IlayAltay/Maks_Kontroller/README.md

# Maks_Kontroller 
полив грядок  
на базе платы макса для бассейна  ё 
4 кнопки  
LCD spi  
часы внешний кварц    
Рабочий вариант усеченый
