IlayAltay/Maks_Kontroller/Автополив-объединены.pdf

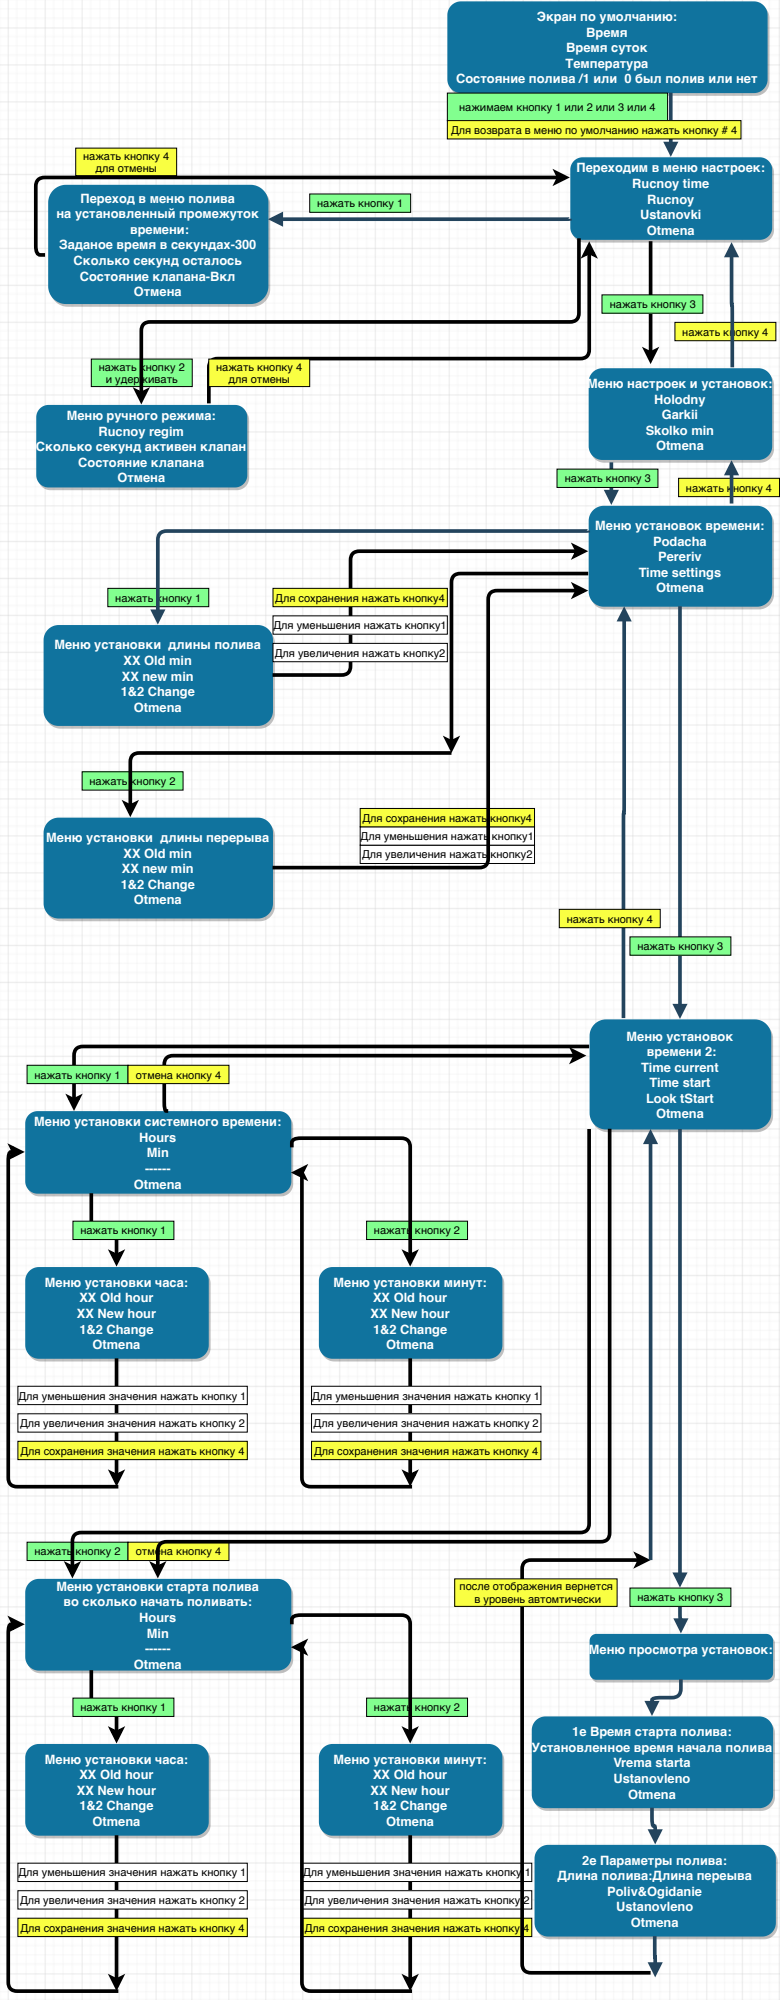
[picture p1: page 1]
Время Время суток Температура; Rucnoy time Rucnoy Ustanovki Otmena; времени:; Отмена; Состояние клапана Отмена; Holodny Garkii Skolko min Otmena; Podacha Pereriv Time settings Otmena; Меню установок времени 2: Time current Time start Look tStart Otmena; Vrema starta Ustanovleno Otmena; нажать кнопку 1; нажать кнопку 4 для отмены; нажать кнопку 2 и удерживать; нажать кнопку 3; нажать кнопку 2; нажать кнопку 4; Hours Min ------ Otmena; отмена кнопку 4; Poliv&Ogidanie Ustanovleno Otmena

Экран по умолчанию:

Состояние полива /1 или 0 был полив или нет

нажимаем кнопку 1 или 2 или 3 или 4

Для возврата в меню по умолчанию нажать кнопку # 4

Переходим в меню настроек:

Переход в меню полива
на установленный промежуток

Заданое время в секундах-300
Сколько секунд осталось
Состояние клапана-Вкл

Меню настроек и установок:

Меню ручного режима:
Rucnoy regim

Сколько секунд активен клапан

Меню установок времени:

Для сохранения нажать кнопку4

Для уменьшения нажать кнопку1

Меню установки длины полива

ХХ Old min
XX new min
1&2 Change
Otmena

Для увеличения нажать кнопку2

Меню установки длины перерыва

Меню установки системного времени:

Меню установки часа:
ХХ Old hour
XX New hour

Меню установки минут:

Для уменьшения значения нажать кнопку 1

Для увеличения значения нажать кнопку 2

Для сохранения значения нажать кнопку 4

Меню установки старта полива
во сколько начать поливать:

после отображения вернется
в уровень автомтически

Меню просмотра установок:

1е Время старта полива:

Установленное время начала полива

2е Параметры полива:
Длина полива:Длина переыва

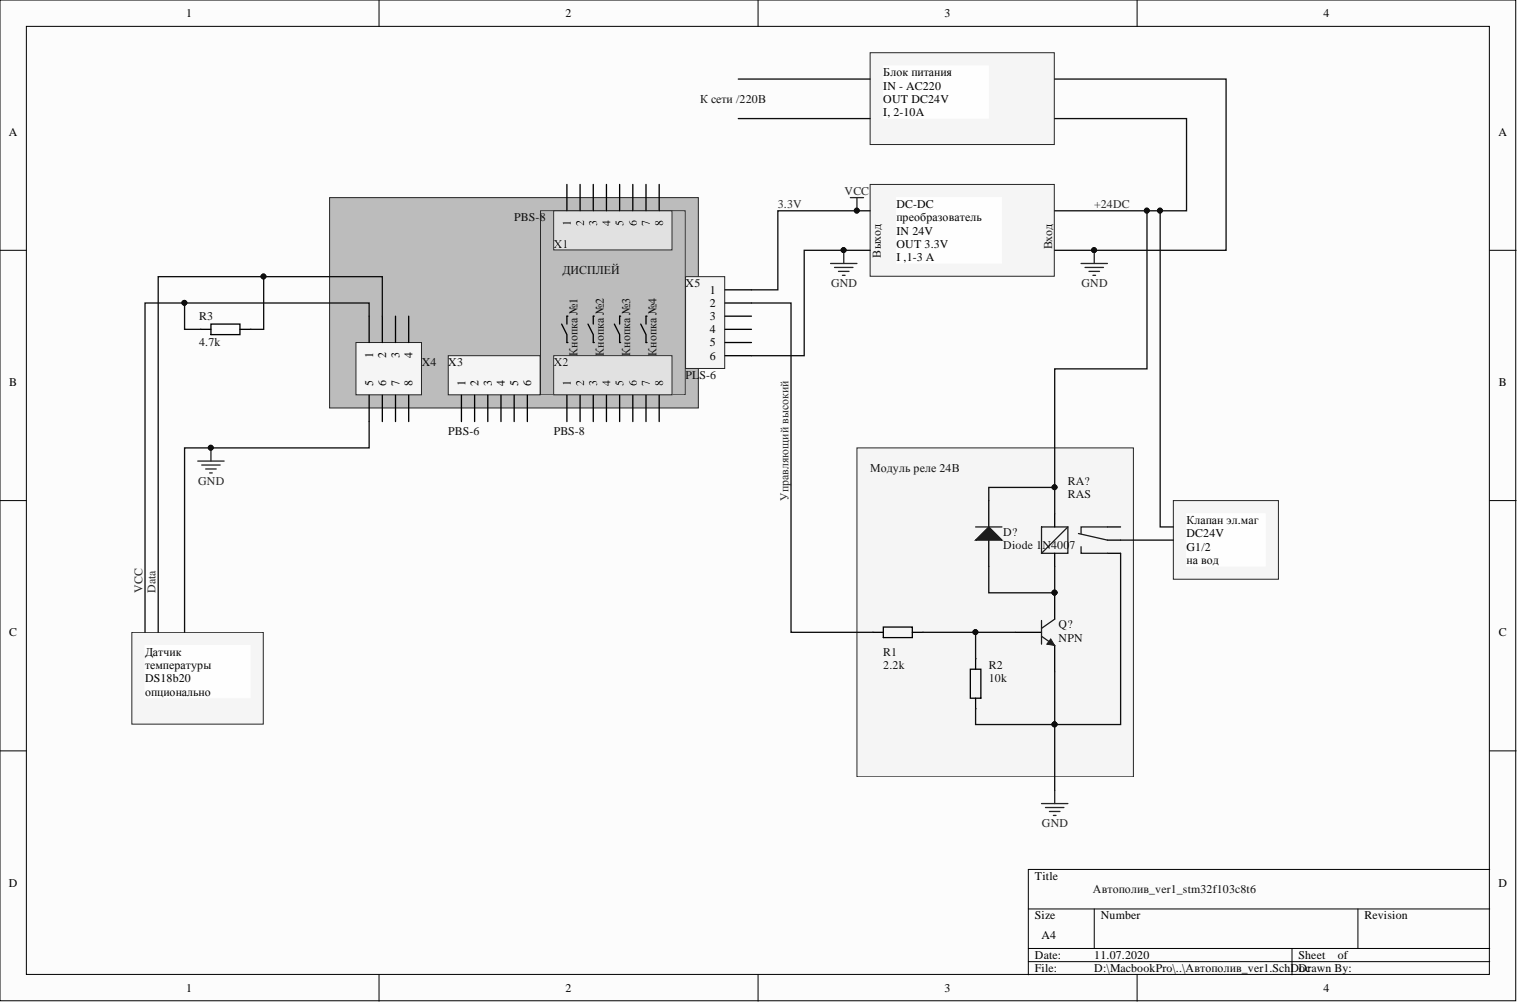
[picture p2: page 3]
Size; umber; Rev; Date:; Sheet o; \Macb; kPro; Авто; ver1.Sch; Docraw; ver1; PBS-8; PBS-6; PLS-6; ИСП; Кнопка №1; Кнопка №2; Кнопка №3; Кнопка №4; итан; К сети /; рео; раз; овател; Вход; Выход; DVCC; ? NPN; рел; Клапан; .маг; Управляющий высокий; Датч; к температу; нал; VCC; Data

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
D | D
C | C
B | B
A | A

Title

Size | Number | Revision

A4

Date: | 11.07.2020 | Sheet of
File: | D:\MacbookPro\..\Автополив_ver1_распиDнrawовкаn Byраз:ьемов.SchDoc

разьем Х1
Входит в плату
соединения с дисплеем
OLED
Распиновка:
1-GND
2-PC8 Светодиод+
3-PA5 -spi sck
4-PA6 -spi miso
5-PA7 -spi mosi
6-PB11 -Data/command
7-PB10 -CSelect
8-VCC +3.3

Разьем X2
Соединения с
кнопками
Входит в плату
соединения с дисплеем
OLED
Распиновка:
1-GND
2-GND
3-NRST
4-PB2
5-PB1
6-PB0
7-PC5

Разьем Х3
Для пргограмматора
Распиновка:
1-PB3 spi1
2-PC0
3-SWDIO
4-GND
5-SWCLK
6-VCC 3.3V

Разьем Х4
Для моудля NRF
Использован для DS18B20
Распиновка:
1-VCC
2-PA3 -data for ds18b20
3-к пин.5 Х1
4-PC4
5-GND
6-PA4
7-К пин3 Х1
8-к пин4 Х1

Разьем Х5
Внешний
Распиновка:
1-VCC
2-PC9 подключен вывод
реле полива
3-PB15 spi_mosi
4-PB13 spi_sck
5-PB14 spi_miso
6-GND

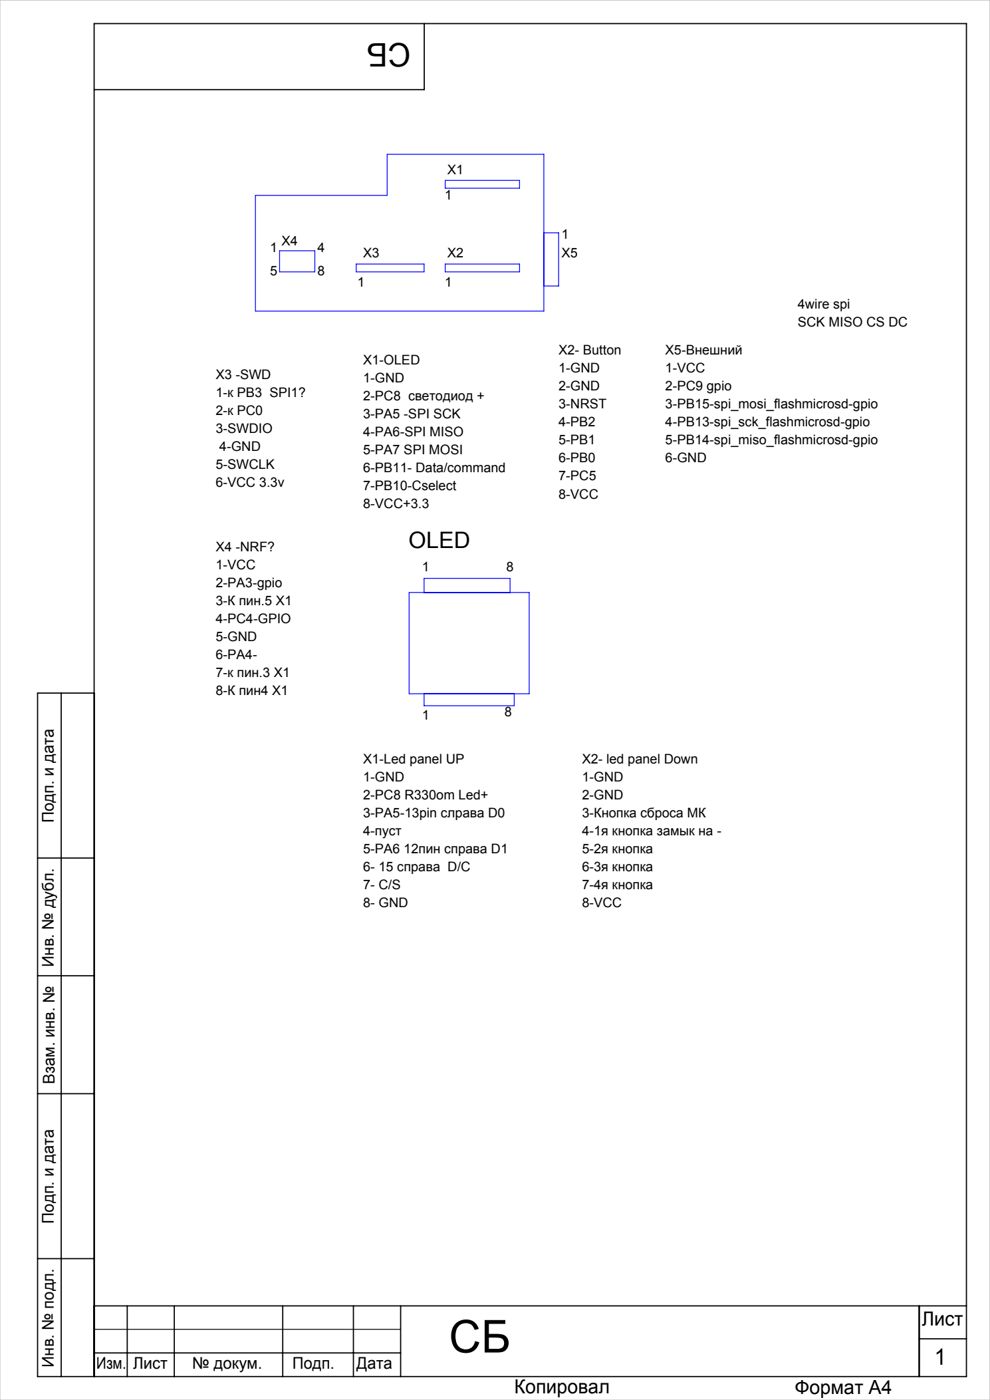
[picture p3: figure]
X4 -NRF? 1-VCC 2-PA3-gpio 3-К пин.5 X1 4-PC4-GPIO 5-GND 6-PA4- 7-к пин.3 X1 8-К пин4 X1; X1-OLED 1-GND 2-PC8 светодиод + 3-PA5 -SPI SCK 4-PA6-SPI MISO 5-PA7 SPI MOSI 6-PB11- Data/command 7-PB10-Cselect 8-VCC+3.3; X2- Button 1-GND 2-GND 3-NRST 4-PB2 5-PB1 6-PB0 7-PC5 8-VCC; X1-Led panel UP 1-GND 2-PC8 R330om Led+ 3-PA5-13pin слрава D0 4-пуст 5-PA6 12пин справа D1 6- 15 справа D/C 7- C/S 8- GND; X2- led panel Down 1-GND 2-GND 3-Кнопка сброса МК 4-1я кнопка замык на - 5-2я кнопка 6-3я кнопка 7-4я кнопка 8-VCC; OLED; 4wire spi SCK MISO CS DC; X5-Внешний 1-VCC 2-PC9 gpio 3-PB15-spi_mosi_flashmicrosd-gpio 4-PB13-spi_sck_flashmicrosd-gpio 5-PB14-spi_miso_flashmicrosd-gpio 6-GND; X3 -SWD 1-к PB3 SPI1? 2-к PC0 3-SWDIO 4-GND 5-SWCLK 6-VCC 3.3v; Инв. № подл.; № докум.; Подп.; Дата; Копировал; Лист; Формат А4; Изм.

Подп. и дата Взам. инв. № Инв. № дубл. Подп. и дата

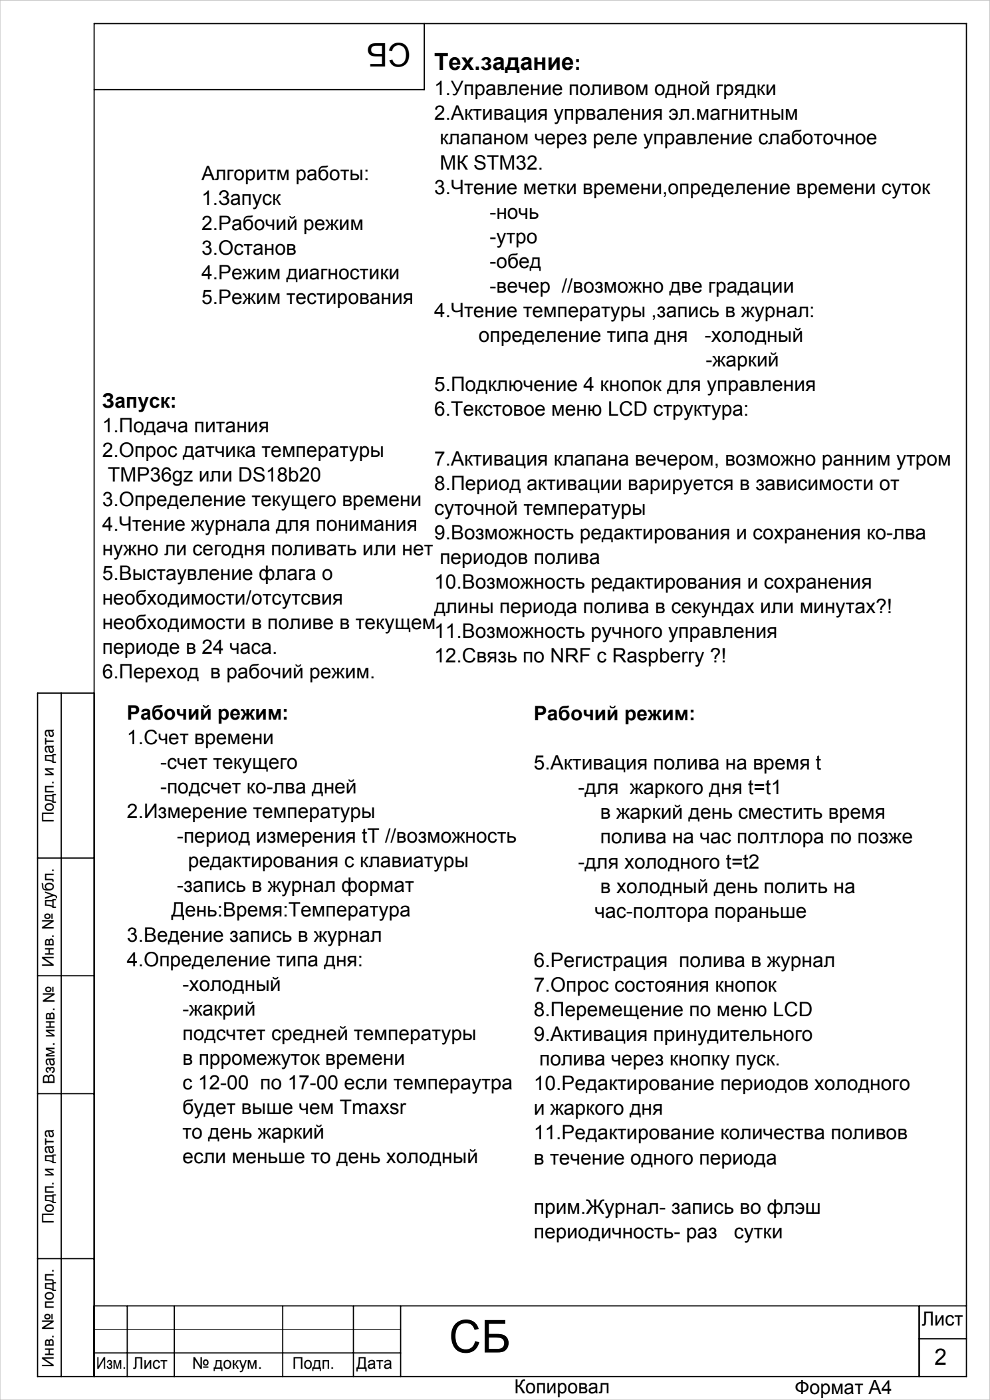
[picture p4: figure]
Алгоритм работы: 1.Запуск 2.Рабочий режим 3.Останов 4.Режим диагностики 5.Режим тестирования; Запуск: 1.Подача питания 2.Опрос датчика температуры TMP36gz или DS18b20 3.Определение текущего времени 4.Чтение журнала для понимания нужно ли сегодня поливать или нет 5.Выстаувление флага о необходимости/отсутсвия необходимости в поливе в текущем периоде в 24 часа. 6.Переход в рабочий режим.; Тех.задание: 1.Управление поливом одной грядки 2.Активация упрваления эл.магнитным; МК STM32.; -ночь -утро -обед -вечер //возможно две градации 4.Чтение температуры ,запись в журнал: определение типа дня -холодный -жаркий 5.Подключение 4 кнопок для управления 6.Текстовое меню LCD структура:; суточной температуры; периодов полива; 11.Возможность ручного управления 12.Связь по NRF с Raspberry ?!; Рабочий режим: 1.Счет времени -счет текущего -подсчет ко-лва дней 2.Измерение температуры -период измерения tT //возможность редактирования с клавиатуры -запись в журнал формат День:Время:Температура 3.Ведение запись в журнал 4.Определение типа дня: -холодный -жакрий подсчтет средней температуры в прромежуток времени с 12-00 по 17-00 если темпераутра будет выше чем Tmaxsr то день жаркий если меньше то день холодный; Рабочий режим:; 5.Активация полива на время t -для жаркого дня t=t1 в жаркий день сместить время полива на час полтлора по позже -для холодного t=t2 в холодный день полить на час-полтора пораньше; 6.Регистрация полива в журнал 7.Опрос состояния кнопок 8.Перемещение по меню LCD 9.Активация принудительного полива через кнопку пуск. 10.Редактирование периодов холодного и жаркого дня 11.Редактирование количества поливов в течение одного периода; прим.Журнал- запись во флэш периодичность- раз сутки; Инв. № подл.; № докум.; Подп.; Дата

клапаном через реле управление слаботочное

3.Чтение метки времени,определение времени суток

7.Активация клапана вечером, возможно ранним утром 8.Период активации варируется в зависимости от

9.Возможность редактирования и сохранения ко-лва

10.Возможность редактирования и сохранения
длины периода полива в секундах или минутах?!

Подп. и дата Взам. инв. № Инв. № дубл. Подп. и дата

Останов:
1.Отключение питания
2.Переключение питание на АКБ 3.Запись текущего состояния в журнал
4.Отключение питания акб

Режим диагностики:
1.Подача питания
2.Проверка функционирования часов 3.Проверка функционирования датчика температуры
4.Проверка функционирования эл.магнитного клапана подачи 5.Выдача результатов

Режим тестирования:
1.Управление эл.магнитым клапаном по нажатию кнопки
2.Режим : кнопка нажата -клапан включен.

Инв. № подл.

№ докум. | Подп. | Дата | 3

Подп. и дата Взам. инв. № Инв. № дубл. Подп. и дата
