IlayAltay/Maks_Kontroller/Автополив_ver1.PDF

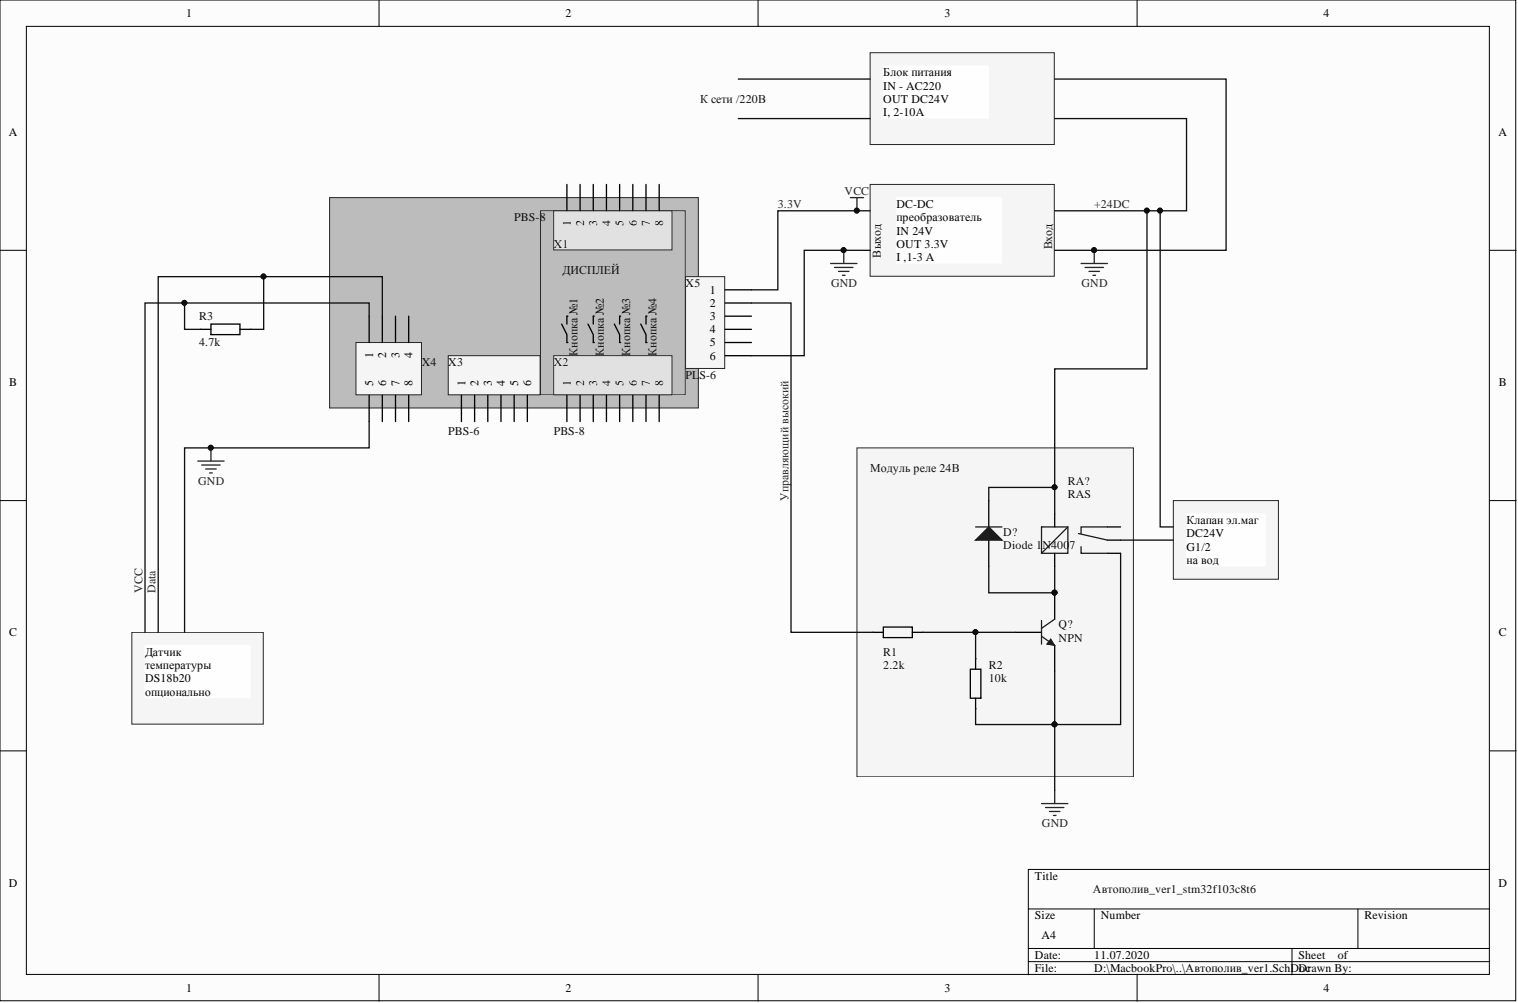
[picture p8: page 1]

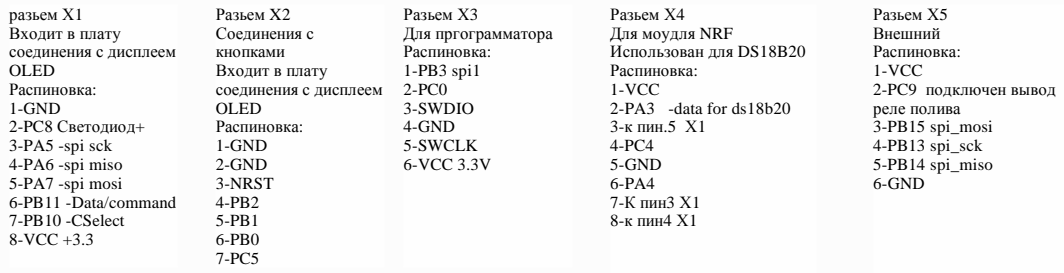
[picture p9: page 2]
