IlayAltay/Maks_Kontroller/Maks_Kontroller/Inc/main.h

#define temperatura_Pin GPIO_PIN_3
#define temperatura_GPIO_Port GPIOA
#define fourth_button_Pin GPIO_PIN_5
#define fourth_button_GPIO_Port GPIOC
#define third_button_Pin GPIO_PIN_0
#define third_button_GPIO_Port GPIOB
#define second_button_Pin GPIO_PIN_1
#define second_button_GPIO_Port GPIOB
#define first_button_Pin GPIO_PIN_2
#define first_button_GPIO_Port GPIOB
#define LED1_Pin GPIO_PIN_8
#define LED1_GPIO_Port GPIOC
#define valve_Pin GPIO_PIN_9
#define valve_GPIO_Port GPIOC
