IlayAltay/Maks_Kontroller/(commit log)

2020-06-10 Ver2
    Рабочая.
    Версия 2я
    Доплнения по настройкам времени старта, по настройкам ситемного времени.Добавлены пункты меню просмотра настроек,задания настроек времени
2020-06-13 Ver3
    Ver3
    Добавлен функционал сохранения во флэш пямять
    Добавлена индикация светодиода в режиме включения клапана
    Исправлен баг при счете времени в фуккции автоматического полива,заключался в переходе через 00 мин-00сек счетчик сбрасывался,для полива длиной более 2х часов необходимо переписать функцию.
    [Maks_Kontroller.ioc, main.c]
2020-07-18 Обновление привязка датчика температуры
    Обновление привязка датчика температуры
